QIU-qiu6/K230-STM32-Gimbal-Tracking/hardware/gimbal-pcb.pdf

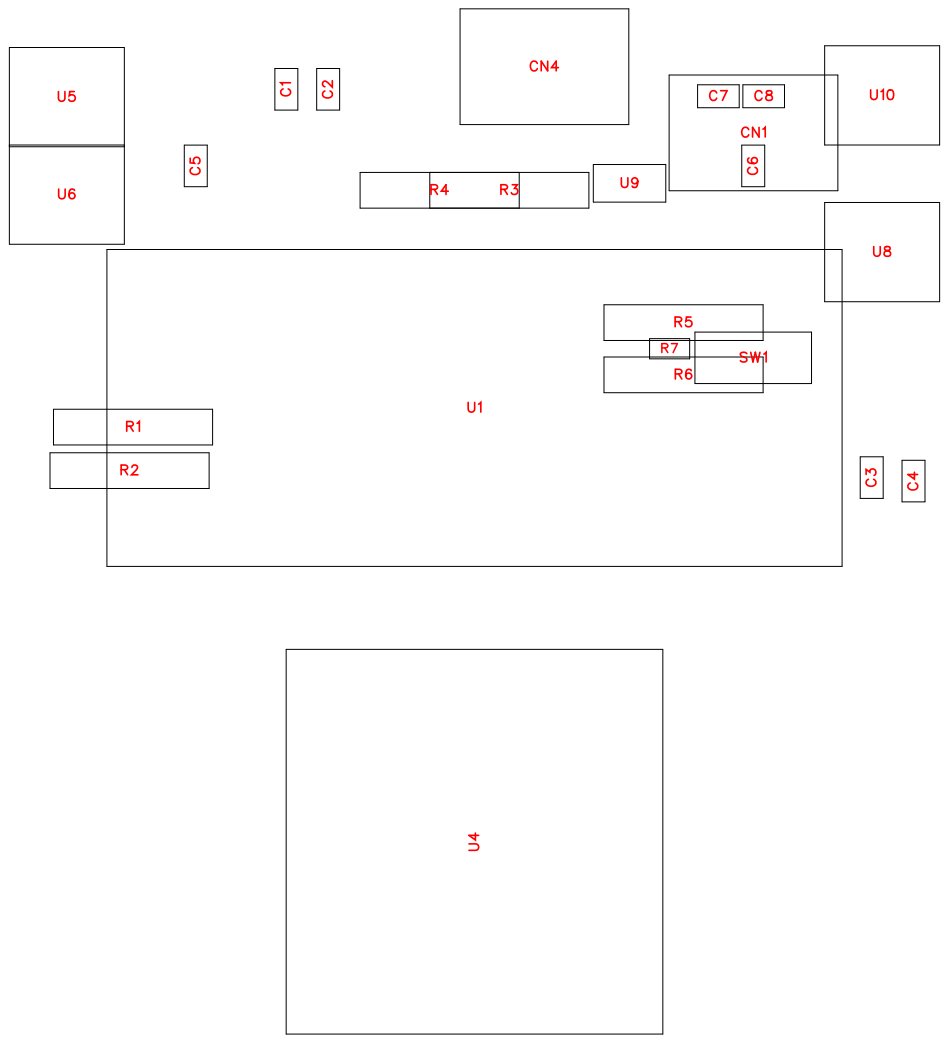
[picture p1: page 1]

U2

U3

No. | Quantity | Comment | Designator | Footprint | Value | Manufacturer Part | Manufacturer | Supplier Part | Supplier
1 | 5 | 100nF | C1,C3,C5,C6,C8 | C0603 | 100nF | CC0603KRX 7R9BB104 | YAGEO(国巨 ) | C14663 | LCSC
2 | 1 | 1uF | C2 | C0603 | 1uF | CL10A105KB 8NNNC | SAMSUNG( ) 三星 | C15849 | LCSC
3 | 2 | 10uF | C4,C7 | C0603 | 10uF | CL10A106KP 8NNNC | SAMSUNG( 三星 ) | C19702 | LCSC
4 | 1 | K230 | CN1 | CONN-TH_4 P-P2.54_KF2 EDGV-2.54-4 P | | KF2EDGV-2. 54-4P | KEFA(科发 ) | C577587 | LCSC
5 | 1 | 电源供电端子 | CN4 | CONN-TH_4 P-P2.54_KF2 EDGV-2.54-4 P | | KF2EDGV-2. 54-4P | KEFA(科发 ) | C577587 | LCSC
6 | 6 | 1k | R1,R2,R3,R4,R5,R6 | RES-TH_BD 2.3-L6.0-P10. 00-D0.6 | 1k | RJ73D2B100 1 | 盛雷城 | C51823310 | LCSC
7 | 1 | 10k | R7 | R0603 | 10k | FRC0603J10 3 TS | FOJAN(富捷 ) | C2930027 | LCSC
8 | 1 | SKHLAAA01 0 | SW1 | SW-TH_L6.0 -W3.5-P6.50 | | SKHLAAA01 0 | ALPSALPIN E(阿尔卑斯阿 尔派 ) | C470263 | LCSC
9 | 1 | LCKFB-DKX-STM32F103 C8T6 | U1 | CONN-TH_L 53.3-W22.9_ STM32F103 C8T6-CARD | | LCKFB-DKX-STM32F103 C8T6 | 立创开发板 | C22396880 | LCSC
10 | 2 | KH-2.54FH-1 X20P-H8.5 | U2,U3 | HDR-TH_20 P-P2.54-V-F- 2 | | KH-2.54FH-1 X20P-H8.5 | kinghelm( 金 航标 ) | C2905423 | LCSC
11 | 1 | oled | U4 | OLED-TH_L2 7.8-W27.2-P 2.54_C99000 33791 | | HS96L03W2 C03 | HS(汉昇 ) | C5248080 | LCSC
12 | 1 | 电机 1供电 | U5 | CONN-TH_2 P-P2.54_DB 2EVC-2.54-2 P-GN | | DB2EVC-2.5 4-2P-GN | DORABO( 地 博电气 ) | C2927493 | LCSC
13 | 1 | 电机 1通信 | U6 | CONN-TH_2 P-P2.54_DB 2EVC-2.54-2 P-GN | | DB2EVC-2.5 4-2P-GN | DORABO( 地 博电气 ) | C2927493 | LCSC
14 | 1 | 电机 2通信 | U8 | CONN-TH_2 P-P2.54_DB 2EVC-2.54-2 P-GN | | DB2EVC-2.5 4-2P-GN | DORABO( 地 博电气 ) | C2927493 | LCSC
15 | 1 | 端子供电的时 候要插上跳线 帽 | U9 | HDR-TH_2P-P2.54-V-M-3 | | HX PZ2.54-1x2P ZZ | hanxia(韩下 ) | C32713268 | LCSC

16

1 | 电机
2供电 | U10 | CONN-TH_2 P-P2.54_DB 2EVC-2.54-2 P-GN

DB2EVC-2.5
4-2P-GN

DORABO(
地
博电气

)

C2927493 LCSC

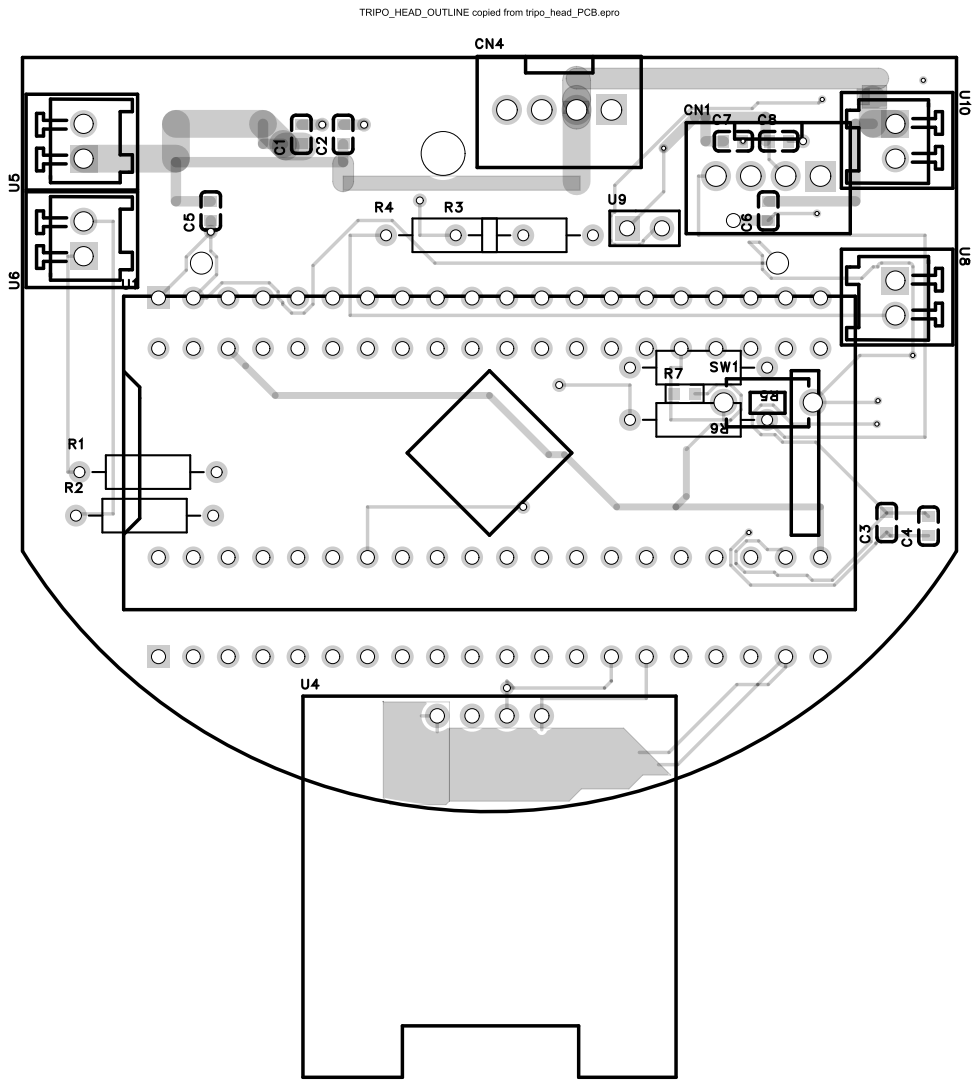
[picture p2: page 5]

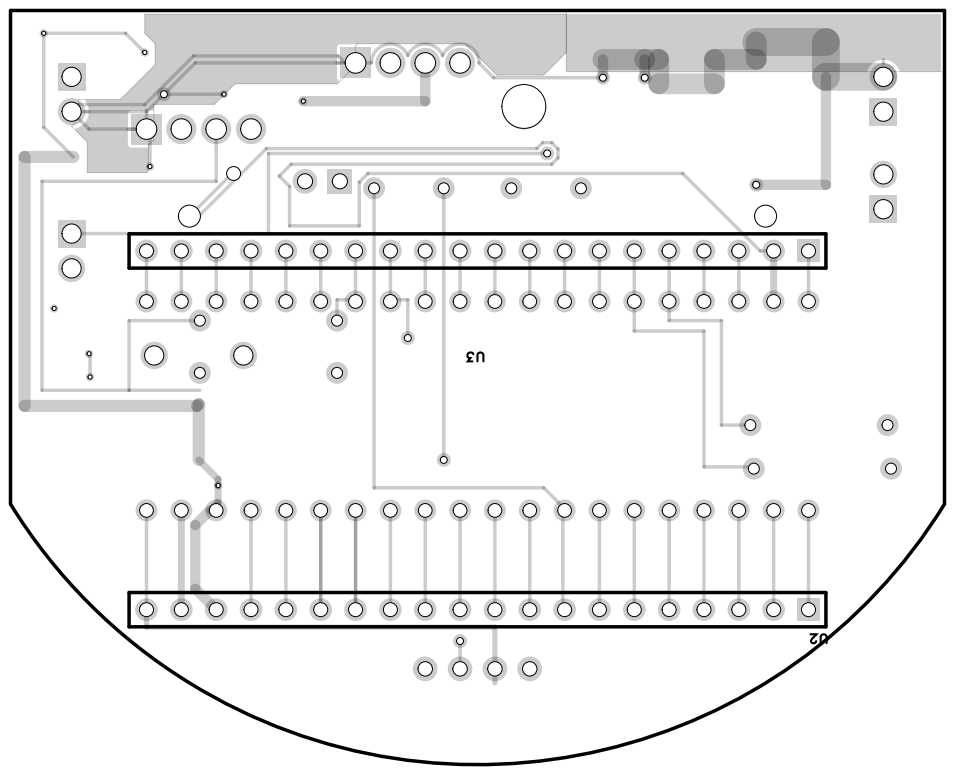
[picture p3: page 6]

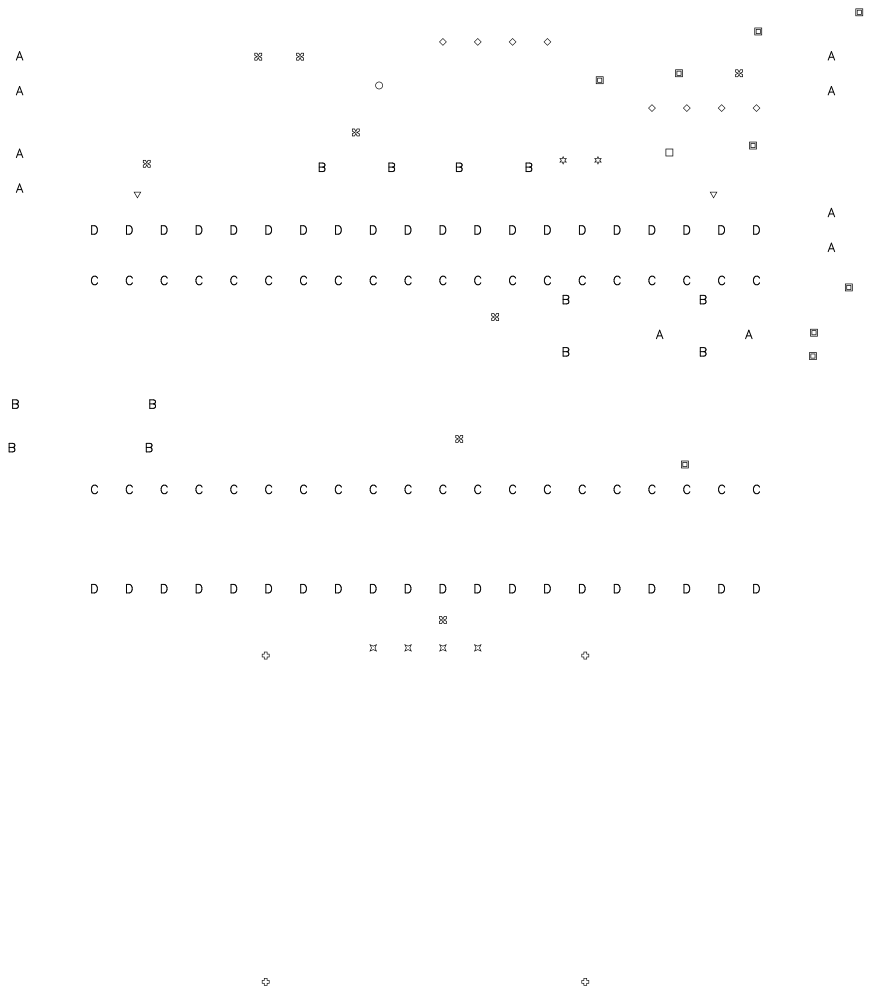
[picture p4: page 7]
