QIU-qiu6/K230-STM32-Gimbal-Tracking/(commit log)

2026-09-12 Publish K230 green tracking and STM32 dual-axis source with documentation
2026-09-13 Add exported PCB reference PDF and document hardware status
2026-09-18 Add editable EasyEDA project with schematics and PCB variants
